rhino9686/Sofishticated/FishTank_app/FishTank/FishTank/Resources/angelfish.jpg

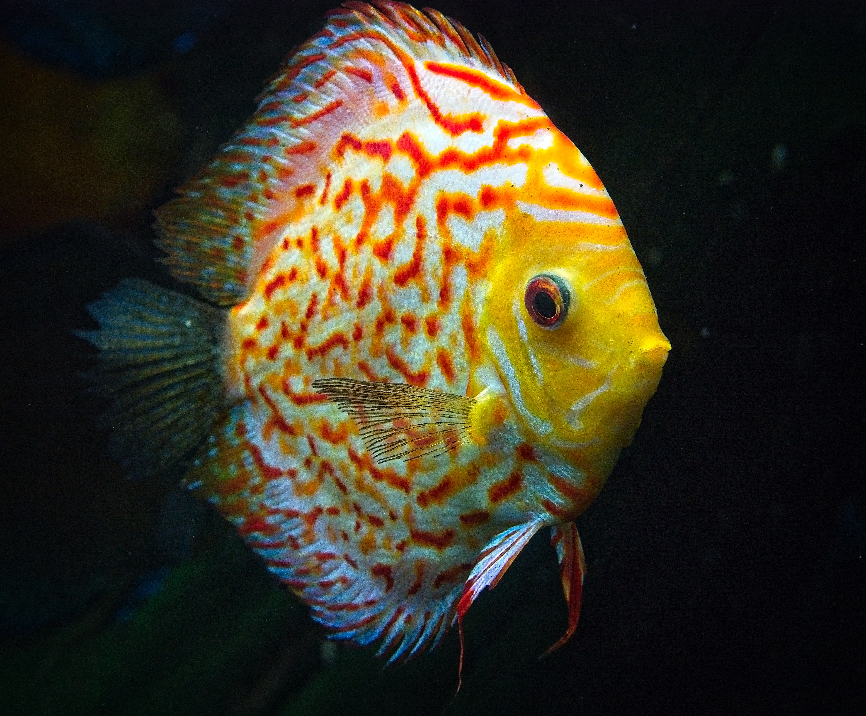
FishTank_app/FishTank/FishTank/Resources/angelfish.jpg
