rhino9686/Sofishticated/FishTank_app/FishTank/FishTank/Resources/appleSnail.jpg

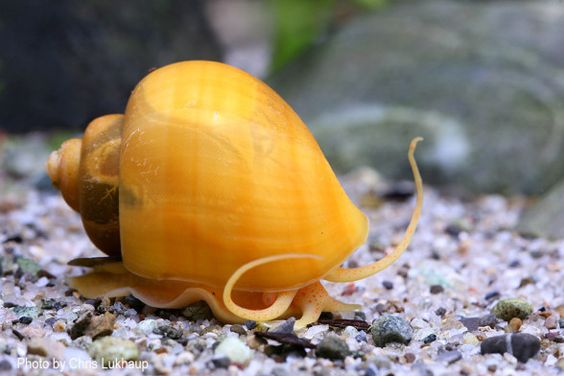
FishTank_app/FishTank/FishTank/Resources/appleSnail.jpg
