rhino9686/Sofishticated/FishTank_app/FishTank/FishTank/Resources/barb.jpg

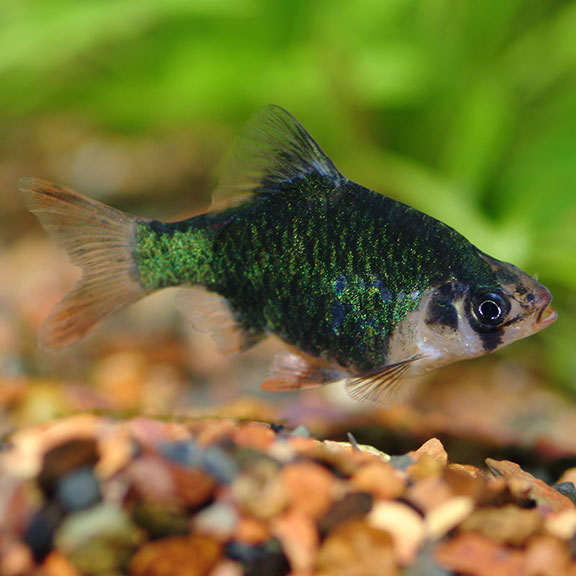
FishTank_app/FishTank/FishTank/Resources/barb.jpg
