rhino9686/Sofishticated/FishTank_app/FishTank/FishTank/Resources/danios.jpg

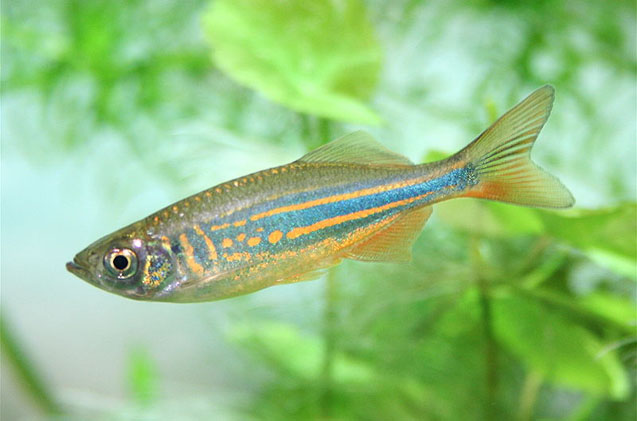
FishTank_app/FishTank/FishTank/Resources/danios.jpg
