rhino9686/Sofishticated/FishTank_app/FishTank/FishTank/Resources/guppy.jpg

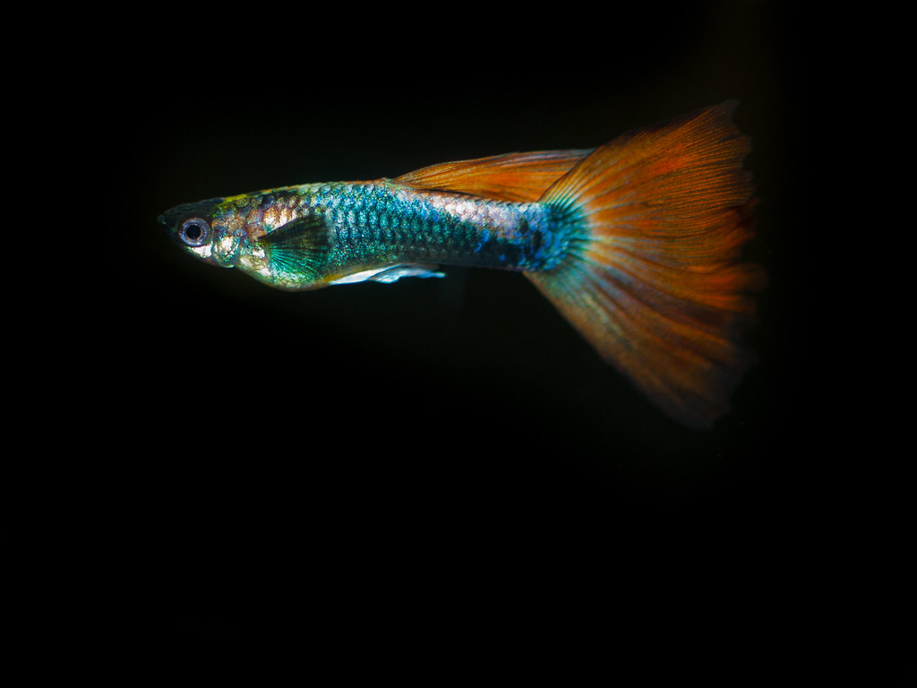
FishTank_app/FishTank/FishTank/Resources/guppy.jpg
