rhino9686/Sofishticated/FishTank_app/FishTank/FishTank/Resources/seaSnail.jpg

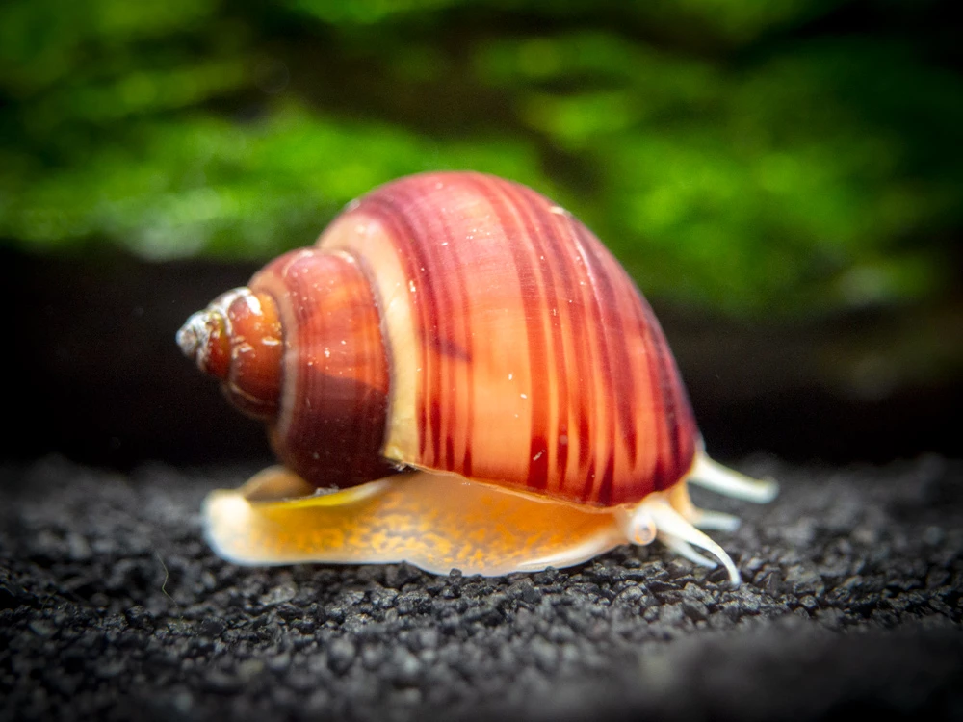
FishTank_app/FishTank/FishTank/Resources/seaSnail.jpg
