rhino9686/Sofishticated/FishTank_app/FishTank/FishTank/Resources/tetra.jpg

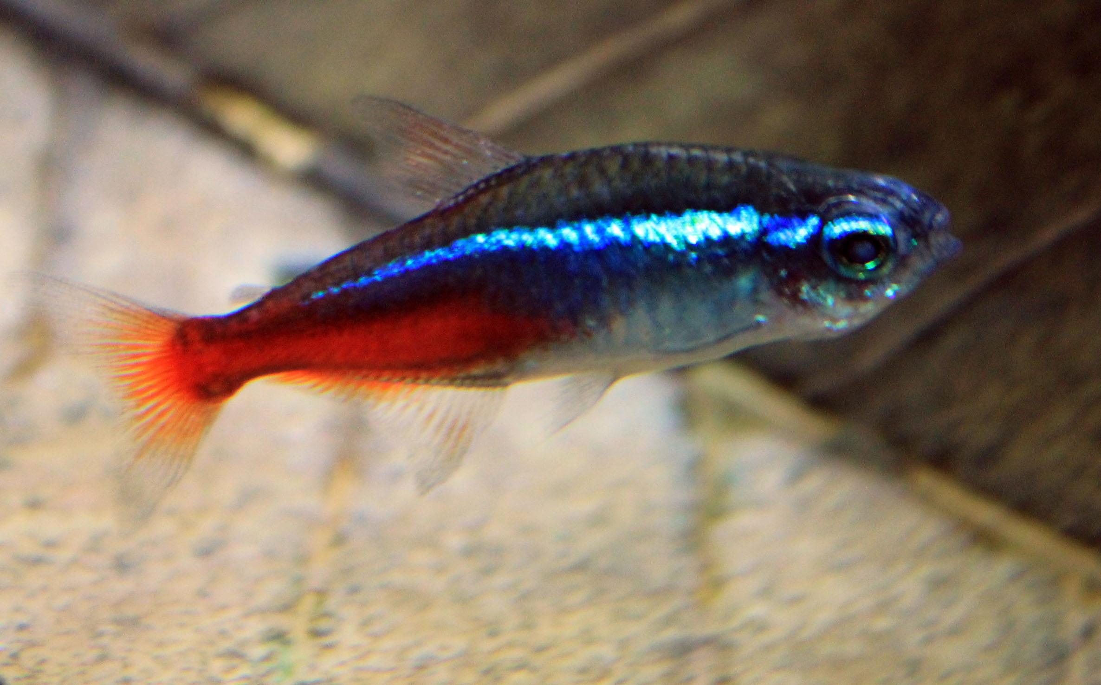
FishTank_app/FishTank/FishTank/Resources/tetra.jpg
