rhino9686/Sofishticated/img/cuties.jpeg

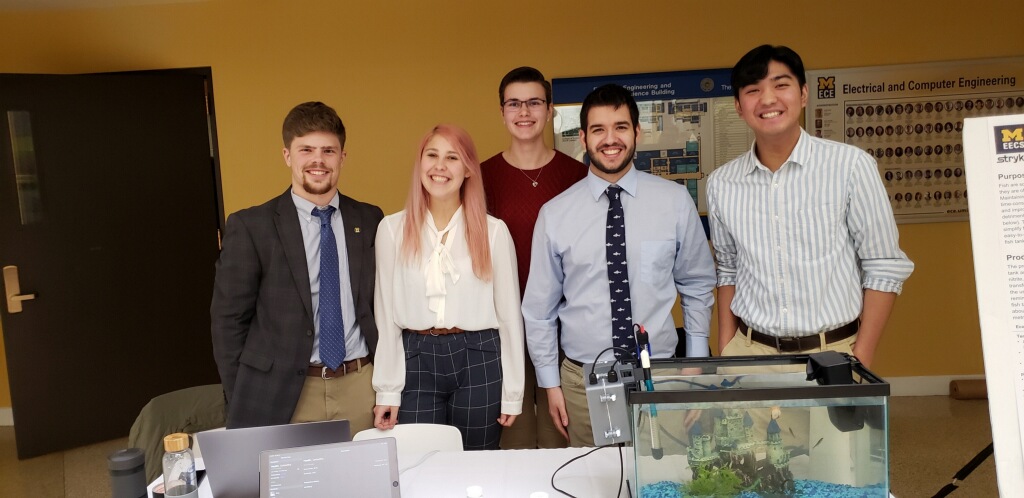
img/cuties.jpeg
