rhino9686/Sofishticated/img/phone_bad.png

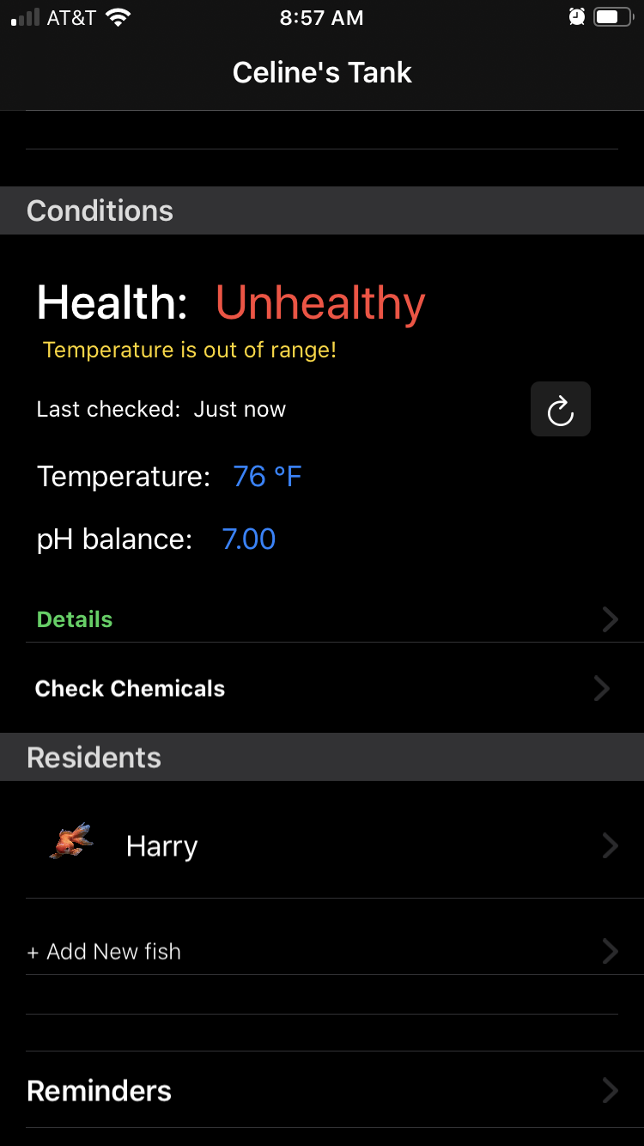
img/phone_bad.png
