rhino9686/Sofishticated/img/side_shot.jpeg

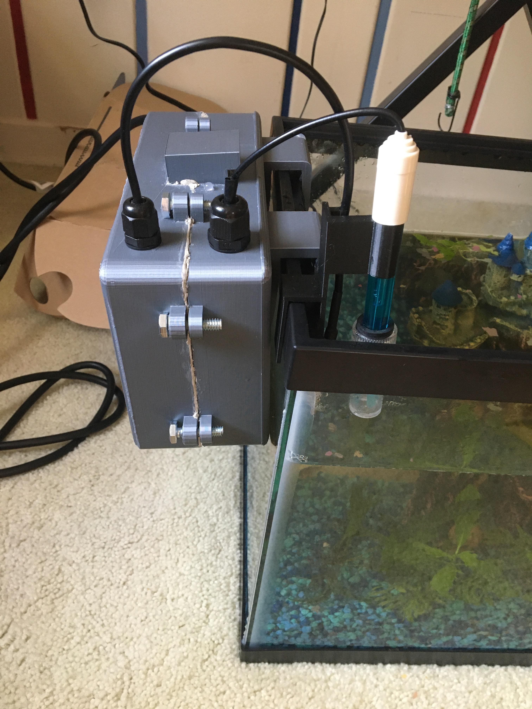
img/side_shot.jpeg
