rhino9686/Sofishticated/img/side_shot_close.jpeg

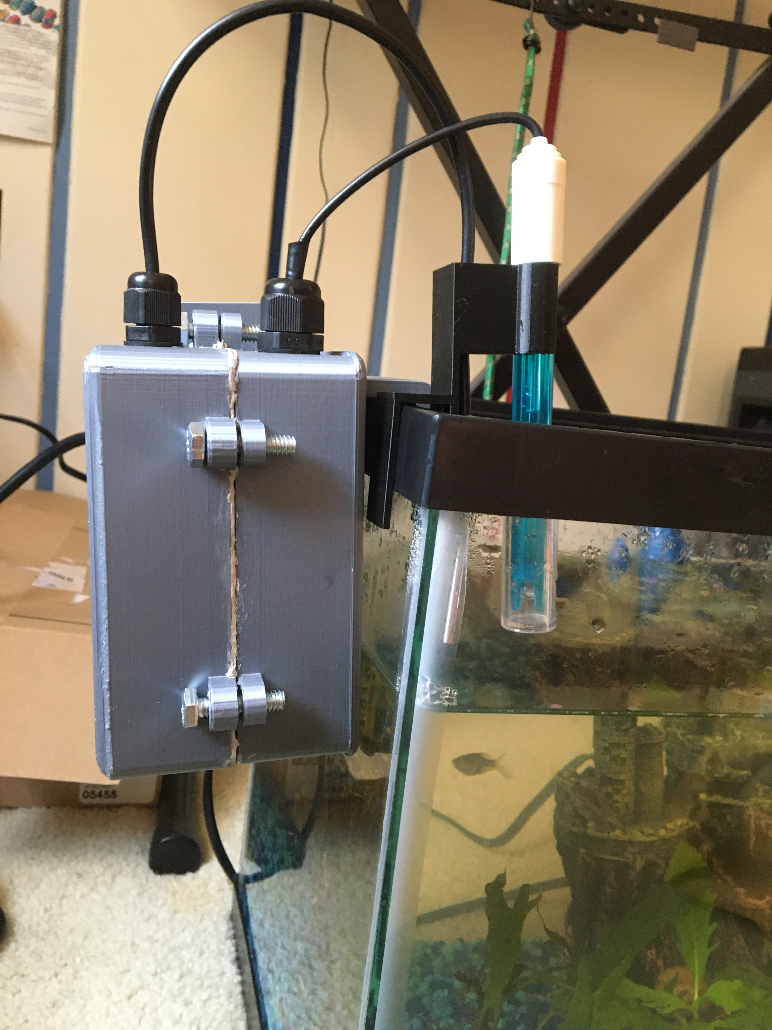
img/side_shot_close.jpeg
