rhino9686/Sofishticated/img/top_shot.jpeg

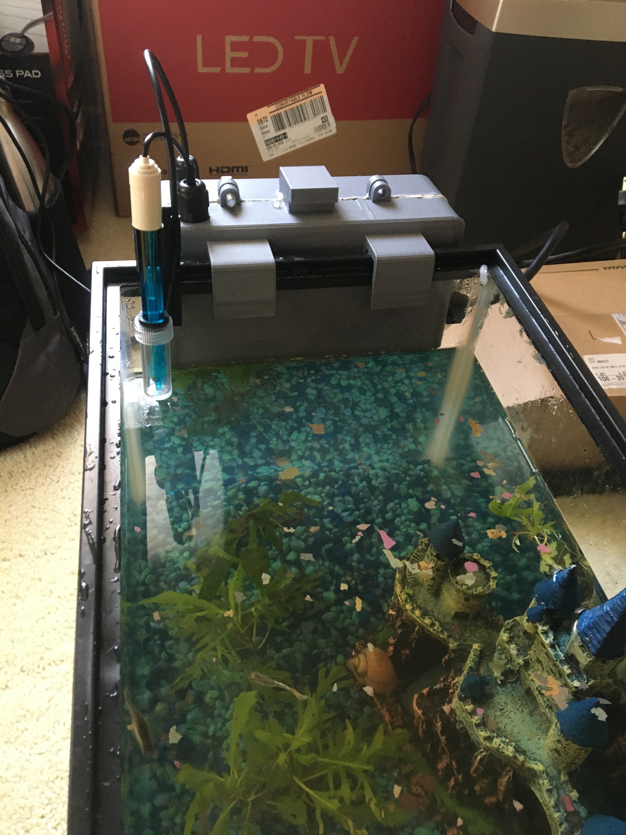
img/top_shot.jpeg
