rhino9686/Sofishticated/LilFishTanks/TestProgram2.txt

------ Build started: Project: ArduinoCore, Configuration: Debug AVR ------
Build started.
Project "ArduinoCore.cppproj" (default targets):
Target "PreBuildEvent" skipped, due to false condition; ('$(PreBuildEvent)'!='') was evaluated as (''!='').
Target "CoreBuild" in file "C:\Program Files (x86)\Atmel\Studio\7.0\Vs\Compiler.targets" from project "d:\users\celine\Documents\Atmel Studio\7.0\ArduinoSketch2\ArduinoSketch2\ArduinoCore\ArduinoCore.cppproj" (target "Build" depends on it):
	Using "RunCompilerTask" task from assembly "C:\Program Files (x86)\Atmel\Studio\7.0\Extensions\Application\AvrGCC.dll".
	Task "RunCompilerTask"
		Shell Utils Path C:\Program Files (x86)\Atmel\Studio\7.0\shellUtils
		C:\Program Files (x86)\Atmel\Studio\7.0\shellUtils\make.exe all --jobs --output-sync 
		Building file: ../src/core/abi.cpp
		Invoking: AVR8/GNU C Compiler : 5.4.0
		"C:\Program Files (x86)\Atmel\Studio\7.0\toolchain\avr8\avr8-gnu-toolchain\bin\avr-g++.exe" -funsigned-char -funsigned-bitfields -DDEBUG -DF_CPU=16000000L -DARDUINO=108010 -DARDUINO_AVR_UNO -DARDUINO_ARCH_AVR -DUSB_VID=0x2341 -DUSB_PID=0x0043 -DUSB_MANUFACTURER="\"Arduino LLC\""  -I"C:\Program Files (x86)\Atmel\Studio\7.0\Packs\atmel\ATmega_DFP\1.3.300\include" -I"..\include\core" -I"..\include\variants\standard"  -Os -fno-threadsafe-statics -ffunction-sections -fdata-sections -fpack-struct -fshort-enums -g2 -w -mmcu=atmega328p -B "C:\Program Files (x86)\Atmel\Studio\7.0\Packs\atmel\ATmega_DFP\1.3.300\gcc\dev\atmega328p" -c -std=gnu++11 -MD -MP -MF "src/core/abi.d" -MT"src/core/abi.d" -MT"src/core/abi.o"   -o "src/core/abi.o" "../src/core/abi.cpp" 
		Finished building: ../src/core/abi.cpp
		Building file: ../src/core/CDC.cpp
		Invoking: AVR8/GNU C Compiler : 5.4.0
		"C:\Program Files (x86)\Atmel\Studio\7.0\toolchain\avr8\avr8-gnu-toolchain\bin\avr-g++.exe" -funsigned-char -funsigned-bitfields -DDEBUG -DF_CPU=16000000L -DARDUINO=108010 -DARDUINO_AVR_UNO -DARDUINO_ARCH_AVR -DUSB_VID=0x2341 -DUSB_PID=0x0043 -DUSB_MANUFACTURER="\"Arduino LLC\""  -I"C:\Program Files (x86)\Atmel\Studio\7.0\Packs\atmel\ATmega_DFP\1.3.300\include" -I"..\include\core" -I"..\include\variants\standard"  -Os -fno-threadsafe-statics -ffunction-sections -fdata-sections -fpack-struct -fshort-enums -g2 -w -mmcu=atmega328p -B "C:\Program Files (x86)\Atmel\Studio\7.0\Packs\atmel\ATmega_DFP\1.3.300\gcc\dev\atmega328p" -c -std=gnu++11 -MD -MP -MF "src/core/CDC.d" -MT"src/core/CDC.d" -MT"src/core/CDC.o"   -o "src/core/CDC.o" "../src/core/CDC.cpp" 
		Finished building: ../src/core/CDC.cpp
		Building file: ../src/core/HardwareSerial.cpp
		Invoking: AVR8/GNU C Compiler : 5.4.0
		"C:\Program Files (x86)\Atmel\Studio\7.0\toolchain\avr8\avr8-gnu-toolchain\bin\avr-g++.exe" -funsigned-char -funsigned-bitfields -DDEBUG -DF_CPU=16000000L -DARDUINO=108010 -DARDUINO_AVR_UNO -DARDUINO_ARCH_AVR -DUSB_VID=0x2341 -DUSB_PID=0x0043 -DUSB_MANUFACTURER="\"Arduino LLC\""  -I"C:\Program Files (x86)\Atmel\Studio\7.0\Packs\atmel\ATmega_DFP\1.3.300\include" -I"..\include\core" -I"..\include\variants\standard"  -Os -fno-threadsafe-statics -ffunction-sections -fdata-sections -fpack-struct -fshort-enums -g2 -w -mmcu=atmega328p -B "C:\Program Files (x86)\Atmel\Studio\7.0\Packs\atmel\ATmega_DFP\1.3.300\gcc\dev\atmega328p" -c -std=gnu++11 -MD -MP -MF "src/core/HardwareSerial.d" -MT"src/core/HardwareSerial.d" -MT"src/core/HardwareSerial.o"   -o "src/core/HardwareSerial.o" "../src/core/HardwareSerial.cpp" 
		Finished building: ../src/core/HardwareSerial.cpp
		Building file: ../src/core/HardwareSerial0.cpp
		Invoking: AVR8/GNU C Compiler : 5.4.0
		"C:\Program Files (x86)\Atmel\Studio\7.0\toolchain\avr8\avr8-gnu-toolchain\bin\avr-g++.exe" -funsigned-char -funsigned-bitfields -DDEBUG -DF_CPU=16000000L -DARDUINO=108010 -DARDUINO_AVR_UNO -DARDUINO_ARCH_AVR -DUSB_VID=0x2341 -DUSB_PID=0x0043 -DUSB_MANUFACTURER="\"Arduino LLC\""  -I"C:\Program Files (x86)\Atmel\Studio\7.0\Packs\atmel\ATmega_DFP\1.3.300\include" -I"..\include\core" -I"..\include\variants\standard"  -Os -fno-threadsafe-statics -ffunction-sections -fdata-sections -fpack-struct -fshort-enums -g2 -w -mmcu=atmega328p -B "C:\Program Files (x86)\Atmel\Studio\7.0\Packs\atmel\ATmega_DFP\1.3.300\gcc\dev\atmega328p" -c -std=gnu++11 -MD -MP -MF "src/core/HardwareSerial0.d" -MT"src/core/HardwareSerial0.d" -MT"src/core/HardwareSerial0.o"   -o "src/core/HardwareSerial0.o" "../src/core/HardwareSerial0.cpp" 
		Finished building: ../src/core/HardwareSerial0.cpp
		Building file: ../src/core/HardwareSerial1.cpp
		Invoking: AVR8/GNU C Compiler : 5.4.0
		"C:\Program Files (x86)\Atmel\Studio\7.0\toolchain\avr8\avr8-gnu-toolchain\bin\avr-g++.exe" -funsigned-char -funsigned-bitfields -DDEBUG -DF_CPU=16000000L -DARDUINO=108010 -DARDUINO_AVR_UNO -DARDUINO_ARCH_AVR -DUSB_VID=0x2341 -DUSB_PID=0x0043 -DUSB_MANUFACTURER="\"Arduino LLC\""  -I"C:\Program Files (x86)\Atmel\Studio\7.0\Packs\atmel\ATmega_DFP\1.3.300\include" -I"..\include\core" -I"..\include\variants\standard"  -Os -fno-threadsafe-statics -ffunction-sections -fdata-sections -fpack-struct -fshort-enums -g2 -w -mmcu=atmega328p -B "C:\Program Files (x86)\Atmel\Studio\7.0\Packs\atmel\ATmega_DFP\1.3.300\gcc\dev\atmega328p" -c -std=gnu++11 -MD -MP -MF "src/core/HardwareSerial1.d" -MT"src/core/HardwareSerial1.d" -MT"src/core/HardwareSerial1.o"   -o "src/core/HardwareSerial1.o" "../src/core/HardwareSerial1.cpp" 
		Finished building: ../src/core/HardwareSerial1.cpp
		Building file: ../src/core/HardwareSerial2.cpp
		Invoking: AVR8/GNU C Compiler : 5.4.0
		"C:\Program Files (x86)\Atmel\Studio\7.0\toolchain\avr8\avr8-gnu-toolchain\bin\avr-g++.exe" -funsigned-char -funsigned-bitfields -DDEBUG -DF_CPU=16000000L -DARDUINO=108010 -DARDUINO_AVR_UNO -DARDUINO_ARCH_AVR -DUSB_VID=0x2341 -DUSB_PID=0x0043 -DUSB_MANUFACTURER="\"Arduino LLC\""  -I"C:\Program Files (x86)\Atmel\Studio\7.0\Packs\atmel\ATmega_DFP\1.3.300\include" -I"..\include\core" -I"..\include\variants\standard"  -Os -fno-threadsafe-statics -ffunction-sections -fdata-sections -fpack-struct -fshort-enums -g2 -w -mmcu=atmega328p -B "C:\Program Files (x86)\Atmel\Studio\7.0\Packs\atmel\ATmega_DFP\1.3.300\gcc\dev\atmega328p" -c -std=gnu++11 -MD -MP -MF "src/core/HardwareSerial2.d" -MT"src/core/HardwareSerial2.d" -MT"src/core/HardwareSerial2.o"   -o "src/core/HardwareSerial2.o" "../src/core/HardwareSerial2.cpp" 
		Finished building: ../src/core/HardwareSerial2.cpp
		Building file: ../src/core/HardwareSerial3.cpp
		Invoking: AVR8/GNU C Compiler : 5.4.0
		"C:\Program Files (x86)\Atmel\Studio\7.0\toolchain\avr8\avr8-gnu-toolchain\bin\avr-g++.exe" -funsigned-char -funsigned-bitfields -DDEBUG -DF_CPU=16000000L -DARDUINO=108010 -DARDUINO_AVR_UNO -DARDUINO_ARCH_AVR -DUSB_VID=0x2341 -DUSB_PID=0x0043 -DUSB_MANUFACTURER="\"Arduino LLC\""  -I"C:\Program Files (x86)\Atmel\Studio\7.0\Packs\atmel\ATmega_DFP\1.3.300\include" -I"..\include\core" -I"..\include\variants\standard"  -Os -fno-threadsafe-statics -ffunction-sections -fdata-sections -fpack-struct -fshort-enums -g2 -w -mmcu=atmega328p -B "C:\Program Files (x86)\Atmel\Studio\7.0\Packs\atmel\ATmega_DFP\1.3.300\gcc\dev\atmega328p" -c -std=gnu++11 -MD -MP -MF "src/core/HardwareSerial3.d" -MT"src/core/HardwareSerial3.d" -MT"src/core/HardwareSerial3.o"   -o "src/core/HardwareSerial3.o" "../src/core/HardwareSerial3.cpp" 
		Finished building: ../src/core/HardwareSerial3.cpp
		Building file: ../src/core/hooks.c
		Invoking: AVR8/GNU C Compiler : 5.4.0
		"C:\Program Files (x86)\Atmel\Studio\7.0\toolchain\avr8\avr8-gnu-toolchain\bin\avr-gcc.exe"  -x c -funsigned-char -funsigned-bitfields -DDEBUG -DF_CPU=16000000L -DARDUINO=108010 -DARDUINO_AVR_UNO -DARDUINO_ARCH_AVR -DUSB_VID=0x2341 -DUSB_PID=0x0043 -DUSB_MANUFACTURER="\"Arduino LLC\""  -I"C:\Program Files (x86)\Atmel\Studio\7.0\Packs\atmel\ATmega_DFP\1.3.300\include" -I"..\include\core" -I"..\include\variants\standard"  -Os -fno-threadsafe-statics -ffunction-sections -fdata-sections -fpack-struct -fshort-enums -g2 -w -mmcu=atmega328p -B "C:\Program Files (x86)\Atmel\Studio\7.0\Packs\atmel\ATmega_DFP\1.3.300\gcc\dev\atmega328p" -c -std=gnu99 -std=gnu11 -MD -MP -MF "src/core/hooks.d" -MT"src/core/hooks.d" -MT"src/core/hooks.o"   -o "src/core/hooks.o" "../src/core/hooks.c" 
		Finished building: ../src/core/hooks.c
		Building file: ../src/core/new.cpp
		Invoking: AVR8/GNU C Compiler : 5.4.0
		"C:\Program Files (x86)\Atmel\Studio\7.0\toolchain\avr8\avr8-gnu-toolchain\bin\avr-g++.exe" -funsigned-char -funsigned-bitfields -DDEBUG -DF_CPU=16000000L -DARDUINO=108010 -DARDUINO_AVR_UNO -DARDUINO_ARCH_AVR -DUSB_VID=0x2341 -DUSB_PID=0x0043 -DUSB_MANUFACTURER="\"Arduino LLC\""  -I"C:\Program Files (x86)\Atmel\Studio\7.0\Packs\atmel\ATmega_DFP\1.3.300\include" -I"..\include\core" -I"..\include\variants\standard"  -Os -fno-threadsafe-statics -ffunction-sections -fdata-sections -fpack-struct -fshort-enums -g2 -w -mmcu=atmega328p -B "C:\Program Files (x86)\Atmel\Studio\7.0\Packs\atmel\ATmega_DFP\1.3.300\gcc\dev\atmega328p" -c -std=gnu++11 -MD -MP -MF "src/core/new.d" -MT"src/core/new.d" -MT"src/core/new.o"   -o "src/core/new.o" "../src/core/new.cpp" 
		Finished building: ../src/core/new.cpp
		Building file: ../src/core/main.cpp
		Invoking: AVR8/GNU C Compiler : 5.4.0
		"C:\Program Files (x86)\Atmel\Studio\7.0\toolchain\avr8\avr8-gnu-toolchain\bin\avr-g++.exe" -funsigned-char -funsigned-bitfields -DDEBUG -DF_CPU=16000000L -DARDUINO=108010 -DARDUINO_AVR_UNO -DARDUINO_ARCH_AVR -DUSB_VID=0x2341 -DUSB_PID=0x0043 -DUSB_MANUFACTURER="\"Arduino LLC\""  -I"C:\Program Files (x86)\Atmel\Studio\7.0\Packs\atmel\ATmega_DFP\1.3.300\include" -I"..\include\core" -I"..\include\variants\standard"  -Os -fno-threadsafe-statics -ffunction-sections -fdata-sections -fpack-struct -fshort-enums -g2 -w -mmcu=atmega328p -B "C:\Program Files (x86)\Atmel\Studio\7.0\Packs\atmel\ATmega_DFP\1.3.300\gcc\dev\atmega328p" -c -std=gnu++11 -MD -MP -MF "src/core/main.d" -MT"src/core/main.d" -MT"src/core/main.o"   -o "src/core/main.o" "../src/core/main.cpp" 
		Finished building: ../src/core/main.cpp
		Building file: ../src/core/IPAddress.cpp
		Invoking: AVR8/GNU C Compiler : 5.4.0
		"C:\Program Files (x86)\Atmel\Studio\7.0\toolchain\avr8\avr8-gnu-toolchain\bin\avr-g++.exe" -funsigned-char -funsigned-bitfields -DDEBUG -DF_CPU=16000000L -DARDUINO=108010 -DARDUINO_AVR_UNO -DARDUINO_ARCH_AVR -DUSB_VID=0x2341 -DUSB_PID=0x0043 -DUSB_MANUFACTURER="\"Arduino LLC\""  -I"C:\Program Files (x86)\Atmel\Studio\7.0\Packs\atmel\ATmega_DFP\1.3.300\include" -I"..\include\core" -I"..\include\variants\standard"  -Os -fno-threadsafe-statics -ffunction-sections -fdata-sections -fpack-struct -fshort-enums -g2 -w -mmcu=atmega328p -B "C:\Program Files (x86)\Atmel\Studio\7.0\Packs\atmel\ATmega_DFP\1.3.300\gcc\dev\atmega328p" -c -std=gnu++11 -MD -MP -MF "src/core/IPAddress.d" -MT"src/core/IPAddress.d" -MT"src/core/IPAddress.o"   -o "src/core/IPAddress.o" "../src/core/IPAddress.cpp" 
		Finished building: ../src/core/IPAddress.cpp
		Building file: ../src/core/PluggableUSB.cpp
		Invoking: AVR8/GNU C Compiler : 5.4.0
		"C:\Program Files (x86)\Atmel\Studio\7.0\toolchain\avr8\avr8-gnu-toolchain\bin\avr-g++.exe" -funsigned-char -funsigned-bitfields -DDEBUG -DF_CPU=16000000L -DARDUINO=108010 -DARDUINO_AVR_UNO -DARDUINO_ARCH_AVR -DUSB_VID=0x2341 -DUSB_PID=0x0043 -DUSB_MANUFACTURER="\"Arduino LLC\""  -I"C:\Program Files (x86)\Atmel\Studio\7.0\Packs\atmel\ATmega_DFP\1.3.300\include" -I"..\include\core" -I"..\include\variants\standard"  -Os -fno-threadsafe-statics -ffunction-sections -fdata-sections -fpack-struct -fshort-enums -g2 -w -mmcu=atmega328p -B "C:\Program Files (x86)\Atmel\Studio\7.0\Packs\atmel\ATmega_DFP\1.3.300\gcc\dev\atmega328p" -c -std=gnu++11 -MD -MP -MF "src/core/PluggableUSB.d" -MT"src/core/PluggableUSB.d" -MT"src/core/PluggableUSB.o"   -o "src/core/PluggableUSB.o" "../src/core/PluggableUSB.cpp" 
		Finished building: ../src/core/PluggableUSB.cpp
		Building file: ../src/core/PreprocessingAssembly/wiring_pulse.S
		Invoking: AVR8/GNU Assembler : 5.4.0
		"C:\Program Files (x86)\Atmel\Studio\7.0\toolchain\avr8\avr8-gnu-toolchain\bin\avr-g++.exe" -Wa,-gdwarf2 -x assembler-with-cpp -c -mmcu=atmega328p -B "C:\Program Files (x86)\Atmel\Studio\7.0\Packs\atmel\ATmega_DFP\1.3.300\gcc\dev\atmega328p" -I "C:\Program Files (x86)\Atmel\Studio\7.0\Packs\atmel\ATmega_DFP\1.3.300\include"  -MD -MP -MF "src/core/PreprocessingAssembly/wiring_pulse.d" -MT"src/core/PreprocessingAssembly/wiring_pulse.d" -MT"src/core/PreprocessingAssembly/wiring_pulse.o" -Wa,-g   -o "src/core/PreprocessingAssembly/wiring_pulse.o" "../src/core/PreprocessingAssembly/wiring_pulse.S" 
		Finished building: ../src/core/PreprocessingAssembly/wiring_pulse.S
		Building file: ../src/core/wiring.c
		Invoking: AVR8/GNU C Compiler : 5.4.0
		"C:\Program Files (x86)\Atmel\Studio\7.0\toolchain\avr8\avr8-gnu-toolchain\bin\avr-gcc.exe"  -x c -funsigned-char -funsigned-bitfields -DDEBUG -DF_CPU=16000000L -DARDUINO=108010 -DARDUINO_AVR_UNO -DARDUINO_ARCH_AVR -DUSB_VID=0x2341 -DUSB_PID=0x0043 -DUSB_MANUFACTURER="\"Arduino LLC\""  -I"C:\Program Files (x86)\Atmel\Studio\7.0\Packs\atmel\ATmega_DFP\1.3.300\include" -I"..\include\core" -I"..\include\variants\standard"  -Os -fno-threadsafe-statics -ffunction-sections -fdata-sections -fpack-struct -fshort-enums -g2 -w -mmcu=atmega328p -B "C:\Program Files (x86)\Atmel\Studio\7.0\Packs\atmel\ATmega_DFP\1.3.300\gcc\dev\atmega328p" -c -std=gnu99 -std=gnu11 -MD -MP -MF "src/core/wiring.d" -MT"src/core/wiring.d" -MT"src/core/wiring.o"   -o "src/core/wiring.o" "../src/core/wiring.c" 
		Finished building: ../src/core/wiring.c
		Building file: ../src/core/WInterrupts.c
		Invoking: AVR8/GNU C Compiler : 5.4.0
		"C:\Program Files (x86)\Atmel\Studio\7.0\toolchain\avr8\avr8-gnu-toolchain\bin\avr-gcc.exe"  -x c -funsigned-char -funsigned-bitfields -DDEBUG -DF_CPU=16000000L -DARDUINO=108010 -DARDUINO_AVR_UNO -DARDUINO_ARCH_AVR -DUSB_VID=0x2341 -DUSB_PID=0x0043 -DUSB_MANUFACTURER="\"Arduino LLC\""  -I"C:\Program Files (x86)\Atmel\Studio\7.0\Packs\atmel\ATmega_DFP\1.3.300\include" -I"..\include\core" -I"..\include\variants\standard"  -Os -fno-threadsafe-statics -ffunction-sections -fdata-sections -fpack-struct -fshort-enums -g2 -w -mmcu=atmega328p -B "C:\Program Files (x86)\Atmel\Studio\7.0\Packs\atmel\ATmega_DFP\1.3.300\gcc\dev\atmega328p" -c -std=gnu99 -std=gnu11 -MD -MP -MF "src/core/WInterrupts.d" -MT"src/core/WInterrupts.d" -MT"src/core/WInterrupts.o"   -o "src/core/WInterrupts.o" "../src/core/WInterrupts.c" 
		Finished building: ../src/core/WInterrupts.c
		Building file: ../src/core/Print.cpp
		Invoking: AVR8/GNU C Compiler : 5.4.0
		"C:\Program Files (x86)\Atmel\Studio\7.0\toolchain\avr8\avr8-gnu-toolchain\bin\avr-g++.exe" -funsigned-char -funsigned-bitfields -DDEBUG -DF_CPU=16000000L -DARDUINO=108010 -DARDUINO_AVR_UNO -DARDUINO_ARCH_AVR -DUSB_VID=0x2341 -DUSB_PID=0x0043 -DUSB_MANUFACTURER="\"Arduino LLC\""  -I"C:\Program Files (x86)\Atmel\Studio\7.0\Packs\atmel\ATmega_DFP\1.3.300\include" -I"..\include\core" -I"..\include\variants\standard"  -Os -fno-threadsafe-statics -ffunction-sections -fdata-sections -fpack-struct -fshort-enums -g2 -w -mmcu=atmega328p -B "C:\Program Files (x86)\Atmel\Studio\7.0\Packs\atmel\ATmega_DFP\1.3.300\gcc\dev\atmega328p" -c -std=gnu++11 -MD -MP -MF "src/core/Print.d" -MT"src/core/Print.d" -MT"src/core/Print.o"   -o "src/core/Print.o" "../src/core/Print.cpp" 
		Finished building: ../src/core/Print.cpp
		Building file: ../src/core/Stream.cpp
		Invoking: AVR8/GNU C Compiler : 5.4.0
		"C:\Program Files (x86)\Atmel\Studio\7.0\toolchain\avr8\avr8-gnu-toolchain\bin\avr-g++.exe" -funsigned-char -funsigned-bitfields -DDEBUG -DF_CPU=16000000L -DARDUINO=108010 -DARDUINO_AVR_UNO -DARDUINO_ARCH_AVR -DUSB_VID=0x2341 -DUSB_PID=0x0043 -DUSB_MANUFACTURER="\"Arduino LLC\""  -I"C:\Program Files (x86)\Atmel\Studio\7.0\Packs\atmel\ATmega_DFP\1.3.300\include" -I"..\include\core" -I"..\include\variants\standard"  -Os -fno-threadsafe-statics -ffunction-sections -fdata-sections -fpack-struct -fshort-enums -g2 -w -mmcu=atmega328p -B "C:\Program Files (x86)\Atmel\Studio\7.0\Packs\atmel\ATmega_DFP\1.3.300\gcc\dev\atmega328p" -c -std=gnu++11 -MD -MP -MF "src/core/Stream.d" -MT"src/core/Stream.d" -MT"src/core/Stream.o"   -o "src/core/Stream.o" "../src/core/Stream.cpp" 
		Finished building: ../src/core/Stream.cpp
		Building file: ../src/core/Tone.cpp
		Invoking: AVR8/GNU C Compiler : 5.4.0
		"C:\Program Files (x86)\Atmel\Studio\7.0\toolchain\avr8\avr8-gnu-toolchain\bin\avr-g++.exe" -funsigned-char -funsigned-bitfields -DDEBUG -DF_CPU=16000000L -DARDUINO=108010 -DARDUINO_AVR_UNO -DARDUINO_ARCH_AVR -DUSB_VID=0x2341 -DUSB_PID=0x0043 -DUSB_MANUFACTURER="\"Arduino LLC\""  -I"C:\Program Files (x86)\Atmel\Studio\7.0\Packs\atmel\ATmega_DFP\1.3.300\include" -I"..\include\core" -I"..\include\variants\standard"  -Os -fno-threadsafe-statics -ffunction-sections -fdata-sections -fpack-struct -fshort-enums -g2 -w -mmcu=atmega328p -B "C:\Program Files (x86)\Atmel\Studio\7.0\Packs\atmel\ATmega_DFP\1.3.300\gcc\dev\atmega328p" -c -std=gnu++11 -MD -MP -MF "src/core/Tone.d" -MT"src/core/Tone.d" -MT"src/core/Tone.o"   -o "src/core/Tone.o" "../src/core/Tone.cpp" 
		Finished building: ../src/core/Tone.cpp
		Building file: ../src/core/USBCore.cpp
		Invoking: AVR8/GNU C Compiler : 5.4.0
		"C:\Program Files (x86)\Atmel\Studio\7.0\toolchain\avr8\avr8-gnu-toolchain\bin\avr-g++.exe" -funsigned-char -funsigned-bitfields -DDEBUG -DF_CPU=16000000L -DARDUINO=108010 -DARDUINO_AVR_UNO -DARDUINO_ARCH_AVR -DUSB_VID=0x2341 -DUSB_PID=0x0043 -DUSB_MANUFACTURER="\"Arduino LLC\""  -I"C:\Program Files (x86)\Atmel\Studio\7.0\Packs\atmel\ATmega_DFP\1.3.300\include" -I"..\include\core" -I"..\include\variants\standard"  -Os -fno-threadsafe-statics -ffunction-sections -fdata-sections -fpack-struct -fshort-enums -g2 -w -mmcu=atmega328p -B "C:\Program Files (x86)\Atmel\Studio\7.0\Packs\atmel\ATmega_DFP\1.3.300\gcc\dev\atmega328p" -c -std=gnu++11 -MD -MP -MF "src/core/USBCore.d" -MT"src/core/USBCore.d" -MT"src/core/USBCore.o"   -o "src/core/USBCore.o" "../src/core/USBCore.cpp" 
		Finished building: ../src/core/USBCore.cpp
		Building file: ../src/core/wiring_analog.c
		Invoking: AVR8/GNU C Compiler : 5.4.0
		"C:\Program Files (x86)\Atmel\Studio\7.0\toolchain\avr8\avr8-gnu-toolchain\bin\avr-gcc.exe"  -x c -funsigned-char -funsigned-bitfields -DDEBUG -DF_CPU=16000000L -DARDUINO=108010 -DARDUINO_AVR_UNO -DARDUINO_ARCH_AVR -DUSB_VID=0x2341 -DUSB_PID=0x0043 -DUSB_MANUFACTURER="\"Arduino LLC\""  -I"C:\Program Files (x86)\Atmel\Studio\7.0\Packs\atmel\ATmega_DFP\1.3.300\include" -I"..\include\core" -I"..\include\variants\standard"  -Os -fno-threadsafe-statics -ffunction-sections -fdata-sections -fpack-struct -fshort-enums -g2 -w -mmcu=atmega328p -B "C:\Program Files (x86)\Atmel\Studio\7.0\Packs\atmel\ATmega_DFP\1.3.300\gcc\dev\atmega328p" -c -std=gnu99 -std=gnu11 -MD -MP -MF "src/core/wiring_analog.d" -MT"src/core/wiring_analog.d" -MT"src/core/wiring_analog.o"   -o "src/core/wiring_analog.o" "../src/core/wiring_analog.c" 
		Finished building: ../src/core/wiring_analog.c
		Building file: ../src/core/wiring_pulse.c
		Invoking: AVR8/GNU C Compiler : 5.4.0
		"C:\Program Files (x86)\Atmel\Studio\7.0\toolchain\avr8\avr8-gnu-toolchain\bin\avr-gcc.exe"  -x c -funsigned-char -funsigned-bitfields -DDEBUG -DF_CPU=16000000L -DARDUINO=108010 -DARDUINO_AVR_UNO -DARDUINO_ARCH_AVR -DUSB_VID=0x2341 -DUSB_PID=0x0043 -DUSB_MANUFACTURER="\"Arduino LLC\""  -I"C:\Program Files (x86)\Atmel\Studio\7.0\Packs\atmel\ATmega_DFP\1.3.300\include" -I"..\include\core" -I"..\include\variants\standard"  -Os -fno-threadsafe-statics -ffunction-sections -fdata-sections -fpack-struct -fshort-enums -g2 -w -mmcu=atmega328p -B "C:\Program Files (x86)\Atmel\Studio\7.0\Packs\atmel\ATmega_DFP\1.3.300\gcc\dev\atmega328p" -c -std=gnu99 -std=gnu11 -MD -MP -MF "src/core/wiring_pulse.d" -MT"src/core/wiring_pulse.d" -MT"src/core/wiring_pulse.o"   -o "src/core/wiring_pulse.o" "../src/core/wiring_pulse.c" 
		Finished building: ../src/core/wiring_pulse.c
		Building file: ../src/core/wiring_shift.c
		Invoking: AVR8/GNU C Compiler : 5.4.0
		"C:\Program Files (x86)\Atmel\Studio\7.0\toolchain\avr8\avr8-gnu-toolchain\bin\avr-gcc.exe"  -x c -funsigned-char -funsigned-bitfields -DDEBUG -DF_CPU=16000000L -DARDUINO=108010 -DARDUINO_AVR_UNO -DARDUINO_ARCH_AVR -DUSB_VID=0x2341 -DUSB_PID=0x0043 -DUSB_MANUFACTURER="\"Arduino LLC\""  -I"C:\Program Files (x86)\Atmel\Studio\7.0\Packs\atmel\ATmega_DFP\1.3.300\include" -I"..\include\core" -I"..\include\variants\standard"  -Os -fno-threadsafe-statics -ffunction-sections -fdata-sections -fpack-struct -fshort-enums -g2 -w -mmcu=atmega328p -B "C:\Program Files (x86)\Atmel\Studio\7.0\Packs\atmel\ATmega_DFP\1.3.300\gcc\dev\atmega328p" -c -std=gnu99 -std=gnu11 -MD -MP -MF "src/core/wiring_shift.d" -MT"src/core/wiring_shift.d" -MT"src/core/wiring_shift.o"   -o "src/core/wiring_shift.o" "../src/core/wiring_shift.c" 
		Finished building: ../src/core/wiring_shift.c
		Building file: ../src/core/wiring_digital.c
		Invoking: AVR8/GNU C Compiler : 5.4.0
		"C:\Program Files (x86)\Atmel\Studio\7.0\toolchain\avr8\avr8-gnu-toolchain\bin\avr-gcc.exe"  -x c -funsigned-char -funsigned-bitfields -DDEBUG -DF_CPU=16000000L -DARDUINO=108010 -DARDUINO_AVR_UNO -DARDUINO_ARCH_AVR -DUSB_VID=0x2341 -DUSB_PID=0x0043 -DUSB_MANUFACTURER="\"Arduino LLC\""  -I"C:\Program Files (x86)\Atmel\Studio\7.0\Packs\atmel\ATmega_DFP\1.3.300\include" -I"..\include\core" -I"..\include\variants\standard"  -Os -fno-threadsafe-statics -ffunction-sections -fdata-sections -fpack-struct -fshort-enums -g2 -w -mmcu=atmega328p -B "C:\Program Files (x86)\Atmel\Studio\7.0\Packs\atmel\ATmega_DFP\1.3.300\gcc\dev\atmega328p" -c -std=gnu99 -std=gnu11 -MD -MP -MF "src/core/wiring_digital.d" -MT"src/core/wiring_digital.d" -MT"src/core/wiring_digital.o"   -o "src/core/wiring_digital.o" "../src/core/wiring_digital.c" 
		Finished building: ../src/core/wiring_digital.c
		Building file: ../src/core/WMath.cpp
		Invoking: AVR8/GNU C Compiler : 5.4.0
		"C:\Program Files (x86)\Atmel\Studio\7.0\toolchain\avr8\avr8-gnu-toolchain\bin\avr-g++.exe" -funsigned-char -funsigned-bitfields -DDEBUG -DF_CPU=16000000L -DARDUINO=108010 -DARDUINO_AVR_UNO -DARDUINO_ARCH_AVR -DUSB_VID=0x2341 -DUSB_PID=0x0043 -DUSB_MANUFACTURER="\"Arduino LLC\""  -I"C:\Program Files (x86)\Atmel\Studio\7.0\Packs\atmel\ATmega_DFP\1.3.300\include" -I"..\include\core" -I"..\include\variants\standard"  -Os -fno-threadsafe-statics -ffunction-sections -fdata-sections -fpack-struct -fshort-enums -g2 -w -mmcu=atmega328p -B "C:\Program Files (x86)\Atmel\Studio\7.0\Packs\atmel\ATmega_DFP\1.3.300\gcc\dev\atmega328p" -c -std=gnu++11 -MD -MP -MF "src/core/WMath.d" -MT"src/core/WMath.d" -MT"src/core/WMath.o"   -o "src/core/WMath.o" "../src/core/WMath.cpp" 
		Finished building: ../src/core/WMath.cpp
		Building file: ../src/core/WString.cpp
		Invoking: AVR8/GNU C Compiler : 5.4.0
		"C:\Program Files (x86)\Atmel\Studio\7.0\toolchain\avr8\avr8-gnu-toolchain\bin\avr-g++.exe" -funsigned-char -funsigned-bitfields -DDEBUG -DF_CPU=16000000L -DARDUINO=108010 -DARDUINO_AVR_UNO -DARDUINO_ARCH_AVR -DUSB_VID=0x2341 -DUSB_PID=0x0043 -DUSB_MANUFACTURER="\"Arduino LLC\""  -I"C:\Program Files (x86)\Atmel\Studio\7.0\Packs\atmel\ATmega_DFP\1.3.300\include" -I"..\include\core" -I"..\include\variants\standard"  -Os -fno-threadsafe-statics -ffunction-sections -fdata-sections -fpack-struct -fshort-enums -g2 -w -mmcu=atmega328p -B "C:\Program Files (x86)\Atmel\Studio\7.0\Packs\atmel\ATmega_DFP\1.3.300\gcc\dev\atmega328p" -c -std=gnu++11 -MD -MP -MF "src/core/WString.d" -MT"src/core/WString.d" -MT"src/core/WString.o"   -o "src/core/WString.o" "../src/core/WString.cpp" 
		Finished building: ../src/core/WString.cpp
		Building target: libArduinoCore.a
		Invoking: AVR8/GNU Archiver : 5.4.0
		C:\Program Files (x86)\Atmel\Studio\7.0\toolchain\avr8\avr8-gnu-toolchain\bin\avr-ar.exe: creating libArduinoCore.a
		"C:\Program Files (x86)\Atmel\Studio\7.0\toolchain\avr8\avr8-gnu-toolchain\bin\avr-ar.exe" -r  -o libArduinoCore.a  src/core/abi.o src/core/CDC.o src/core/HardwareSerial.o src/core/HardwareSerial0.o src/core/HardwareSerial1.o src/core/HardwareSerial2.o src/core/HardwareSerial3.o src/core/hooks.o src/core/IPAddress.o src/core/main.o src/core/new.o src/core/PluggableUSB.o src/core/PreprocessingAssembly/wiring_pulse.o src/core/Print.o src/core/Stream.o src/core/Tone.o src/core/USBCore.o src/core/WInterrupts.o src/core/wiring.o src/core/wiring_analog.o src/core/wiring_digital.o src/core/wiring_pulse.o src/core/wiring_shift.o src/core/WMath.o src/core/WString.o   
		Finished building target: libArduinoCore.a
	Done executing task "RunCompilerTask".
	Using "RunOutputFileVerifyTask" task from assembly "C:\Program Files (x86)\Atmel\Studio\7.0\Extensions\Application\AvrGCC.dll".
	Task "RunOutputFileVerifyTask"
	Done executing task "RunOutputFileVerifyTask".
Done building target "CoreBuild" in project "ArduinoCore.cppproj".
Target "PostBuildEvent" skipped, due to false condition; ('$(PostBuildEvent)' != '') was evaluated as ('' != '').
Target "Build" in file "C:\Program Files (x86)\Atmel\Studio\7.0\Vs\Avr.common.targets" from project "d:\users\celine\Documents\Atmel Studio\7.0\ArduinoSketch2\ArduinoSketch2\ArduinoCore\ArduinoCore.cppproj" (entry point):
Done building target "Build" in project "ArduinoCore.cppproj".
Done building project "ArduinoCore.cppproj".

Build succeeded.
------ Build started: Project: Blink, Configuration: Debug AVR ------
Build started.
Project "Blink.cppproj" (default targets):
Target "PreBuildEvent" skipped, due to false condition; ('$(PreBuildEvent)'!='') was evaluated as (''!='').
Target "CoreBuild" in file "C:\Program Files (x86)\Atmel\Studio\7.0\Vs\Compiler.targets" from project "d:\users\celine\Documents\Atmel Studio\7.0\ArduinoSketch2\ArduinoSketch2\Blink\Blink.cppproj" (target "Build" depends on it):
	Using "RunCompilerTask" task from assembly "C:\Program Files (x86)\Atmel\Studio\7.0\Extensions\Application\AvrGCC.dll".
	Task "RunCompilerTask"
		Shell Utils Path C:\Program Files (x86)\Atmel\Studio\7.0\shellUtils
		C:\Program Files (x86)\Atmel\Studio\7.0\shellUtils\make.exe all --jobs --output-sync 
		Building file: .././Sketch.cpp
		Invoking: AVR8/GNU C Compiler : 5.4.0
		"C:\Program Files (x86)\Atmel\Studio\7.0\toolchain\avr8\avr8-gnu-toolchain\bin\avr-g++.exe" -funsigned-char -funsigned-bitfields -DDEBUG -DF_CPU=16000000L -DARDUINO=108010 -DARDUINO_AVR_UNO -DARDUINO_ARCH_AVR -DUSB_VID=0x2341 -DUSB_PID=0x0043 -DUSB_MANUFACTURER="\"Arduino LLC\""  -I"C:\Program Files (x86)\Atmel\Studio\7.0\Packs\atmel\ATmega_DFP\1.3.300\include" -I"..\\..\ArduinoCore\include\core" -I"..\\..\ArduinoCore\include\variants\standard"  -Os -fno-threadsafe-statics -ffunction-sections -fdata-sections -fpack-struct -fshort-enums -g2 -w -mmcu=atmega328p -B "C:\Program Files (x86)\Atmel\Studio\7.0\Packs\atmel\ATmega_DFP\1.3.300\gcc\dev\atmega328p" -c -std=gnu++11 -MD -MP -MF "Sketch.d" -MT"Sketch.d" -MT"Sketch.o"   -o "Sketch.o" ".././Sketch.cpp" 
		Finished building: .././Sketch.cpp
		Building target: Blink.elf
		Invoking: AVR8/GNU Linker : 5.4.0
		"C:\Program Files (x86)\Atmel\Studio\7.0\toolchain\avr8\avr8-gnu-toolchain\bin\avr-g++.exe" -o Blink.elf  Sketch.o   -Wl,-Map="Blink.map" -Wl,--start-group -Wl,-lm -Wl,-lArduinoCore  -Wl,--end-group -Wl,-L"d:\users\celine\Documents\Atmel Studio\7.0\ArduinoSketch2\ArduinoSketch2\ArduinoCore\Debug"  -Wl,--gc-sections -mmcu=atmega328p -B "C:\Program Files (x86)\Atmel\Studio\7.0\Packs\atmel\ATmega_DFP\1.3.300\gcc\dev\atmega328p" -Os  
		Finished building target: Blink.elf
		"C:\Program Files (x86)\Atmel\Studio\7.0\toolchain\avr8\avr8-gnu-toolchain\bin\avr-objcopy.exe" -O ihex -R .eeprom -R .fuse -R .lock -R .signature -R .user_signatures  "Blink.elf" "Blink.hex"
		"C:\Program Files (x86)\Atmel\Studio\7.0\toolchain\avr8\avr8-gnu-toolchain\bin\avr-objcopy.exe" -j .eeprom  --set-section-flags=.eeprom=alloc,load --change-section-lma .eeprom=0  --no-change-warnings -O ihex "Blink.elf" "Blink.eep" || exit 0
		"C:\Program Files (x86)\Atmel\Studio\7.0\toolchain\avr8\avr8-gnu-toolchain\bin\avr-objdump.exe" -h -S "Blink.elf" > "Blink.lss"
		"C:\Program Files (x86)\Atmel\Studio\7.0\toolchain\avr8\avr8-gnu-toolchain\bin\avr-objcopy.exe" -O srec -R .eeprom -R .fuse -R .lock -R .signature -R .user_signatures "Blink.elf" "Blink.srec"
		"C:\Program Files (x86)\Atmel\Studio\7.0\toolchain\avr8\avr8-gnu-toolchain\bin\avr-size.exe" "Blink.elf"
		   text	   data	    bss	    dec	    hex	filename
		   1066	      0	      9	   1075	    433	Blink.elf
	Done executing task "RunCompilerTask".
	Using "RunOutputFileVerifyTask" task from assembly "C:\Program Files (x86)\Atmel\Studio\7.0\Extensions\Application\AvrGCC.dll".
	Task "RunOutputFileVerifyTask"
				Program Memory Usage 	:	1066 bytes   3.3 % Full
				Data Memory Usage 		:	9 bytes   0.4 % Full
				Warning: Memory Usage estimation may not be accurate if there are sections other than .text sections in ELF file
	Done executing task "RunOutputFileVerifyTask".
Done building target "CoreBuild" in project "Blink.cppproj".
Target "PostBuildEvent" skipped, due to false condition; ('$(PostBuildEvent)' != '') was evaluated as ('' != '').
Target "Build" in file "C:\Program Files (x86)\Atmel\Studio\7.0\Vs\Avr.common.targets" from project "d:\users\celine\Documents\Atmel Studio\7.0\ArduinoSketch2\ArduinoSketch2\Blink\Blink.cppproj" (entry point):
Done building target "Build" in project "Blink.cppproj".
Done building project "Blink.cppproj".

Build succeeded.
========== Build: 2 succeeded or up-to-date, 0 failed, 0 skipped ==========
