rhino9686/Sofishticated/(commit log)

2019-10-07 Basic color sensor test and started on bit banging for class
2019-10-09 Removed color sensor files from this branch
2019-10-09 OneWire Protocol for Temperature Sensor
2019-10-15 Basic color sensor interface to calibrate, store, load, and test
2019-10-17 Added sample colors
2019-10-17 Created basic outline of Wifi interrupt, and color sensor, temp, ph tasks
2019-10-17 Added color sensor code to ammonia, nitrite, and nitrate tasks
2019-10-21 Added LED
2019-10-21 Added LED to main project
2019-10-21 Turn off LED after color scanning is done
2019-10-21 Added check for no test strip inserted
2019-10-21 Added pH Sensor Arduino source file
2019-10-22 Added pH sensor to RTOS code
2019-10-23 Added temperature sensor reads
2019-10-23 Fixed temp sensor build errors
    [OneWire.cpp, tempSensor.h]
2019-10-24 Testing all tasks, adjusted temperature sensor to read on every task
2019-10-25 RAY: Added temperature compensation for ph
2019-10-28 Color sensor only activates when seeing a valid test strip value
2019-11-08 Fixed UI arrangement, added a dummy refresh button to update temperature and pH vals
2019-11-11 added better device drivers, reminder support for app
2019-11-12 better fish detail page, worked on Wi-Fi chip drivers
2019-11-21 Started debugging on PCB
2019-11-21 Combined tasks for color sensor and ph and temp
2019-11-22 Added some color sensor values
2019-11-22 refactored file structure of drivers, made test
2019-11-22 fixed app stat refreshing
    [WifiChipTester.ino, deviceDataDrivers.ino]
2019-11-22 Fixed pH sensor, added semaphore for color sensor, added custom serial port
    [main.cpp, phSensor.cpp]
2019-11-25 started stepper page for Testing Chemicals
2019-11-25 Fixed Sempahore memory issue and added temperature relay control
    [OneWire.cpp, main.cpp, phSensor.cpp, tempSensor.h]
2019-11-25 Fixed temperature relay units
    [main.cpp]
2019-11-26 removed extra pH sensor code
2019-11-26 got Wi-Fi Chip to App working with Temperature and pH
2019-11-27 Adjusted pH thresholds and fixed temp sensor
    [OneWire.cpp, main.cpp, phSensor.cpp, tempSensor.h]
2019-11-27 Updated color sensor values and tested relay
2019-11-30 added Temperature and pH history Graphs
2019-12-05 added average Temperature sending to tank
